t3357065474-cloud/STM32-Digital-Synchronous-Buck-Converter/实物PCB正面.jpg

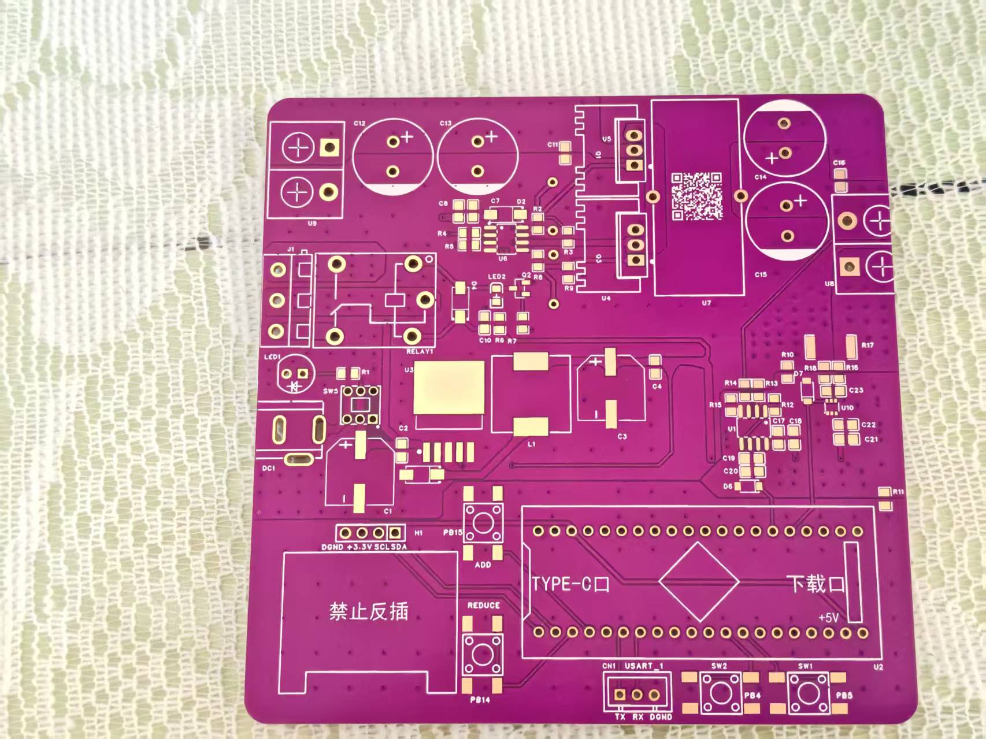
实物PCB正面.jpg
