t3357065474-cloud/STM32-Digital-Synchronous-Buck-Converter/2D_PCB2_2026-07-11.png

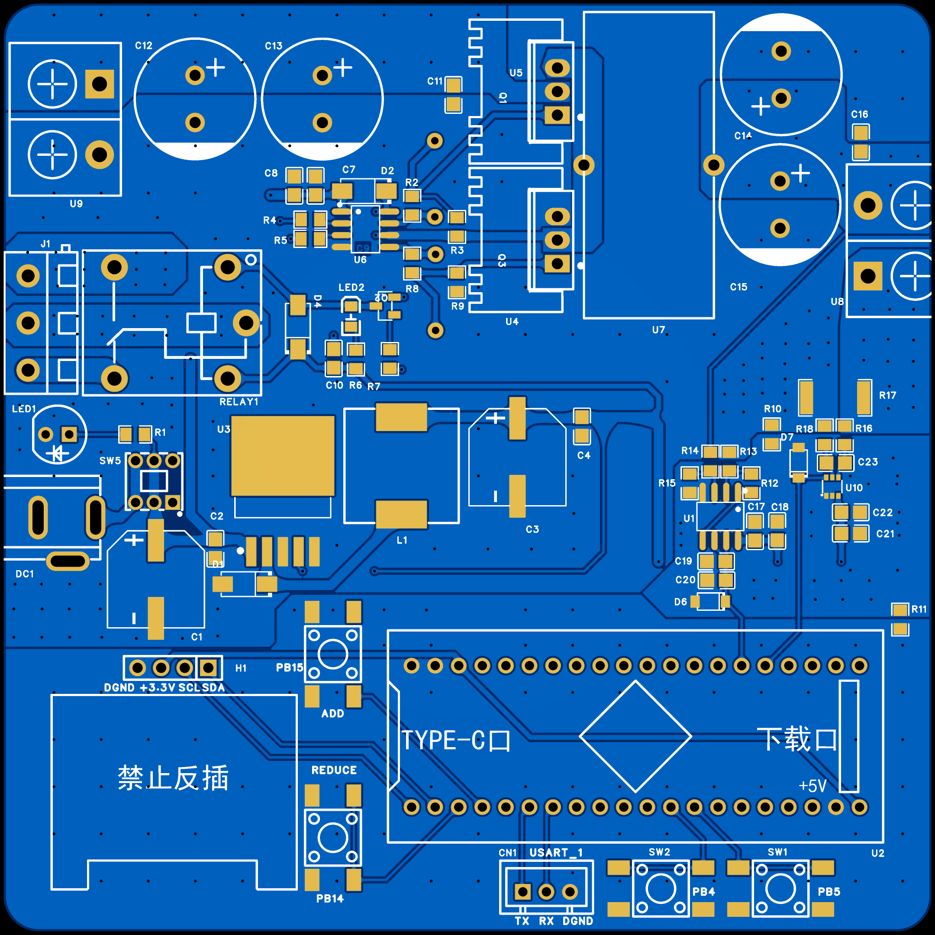
2D_PCB2_2026-07-11.png
