t3357065474-cloud/STM32-Digital-Synchronous-Buck-Converter/3D_PCB2_2026-07-11.png

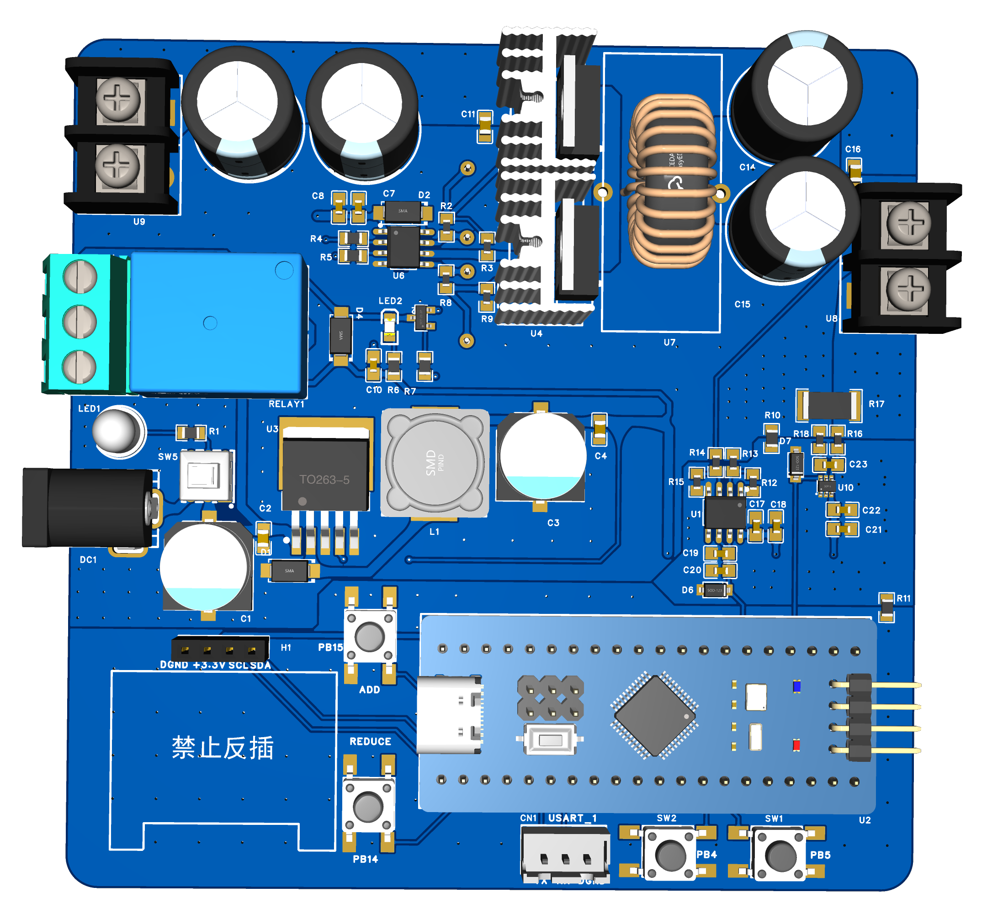
3D_PCB2_2026-07-11.png
