t3357065474-cloud/STM32-Digital-Synchronous-Buck-Converter/PCB_PCB2_2026-07-11.png

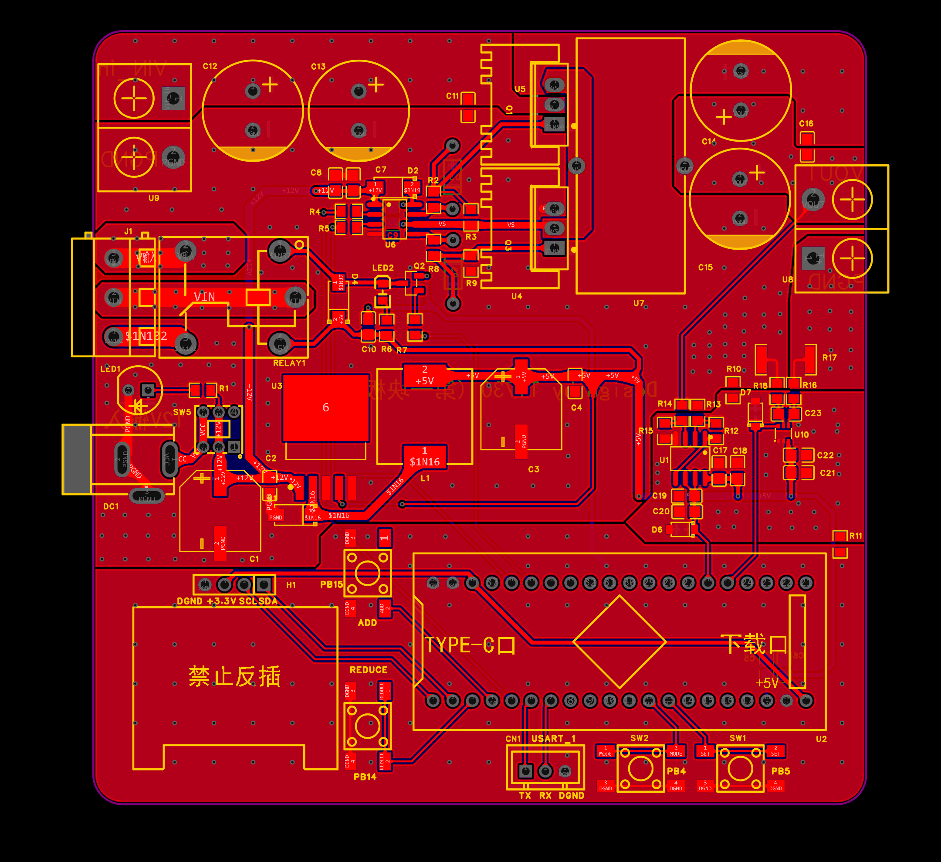
PCB_PCB2_2026-07-11.png
