t3357065474-cloud/STM32-Digital-Synchronous-Buck-Converter/SCH_Schematic1_1-P1_2026-07-11.png

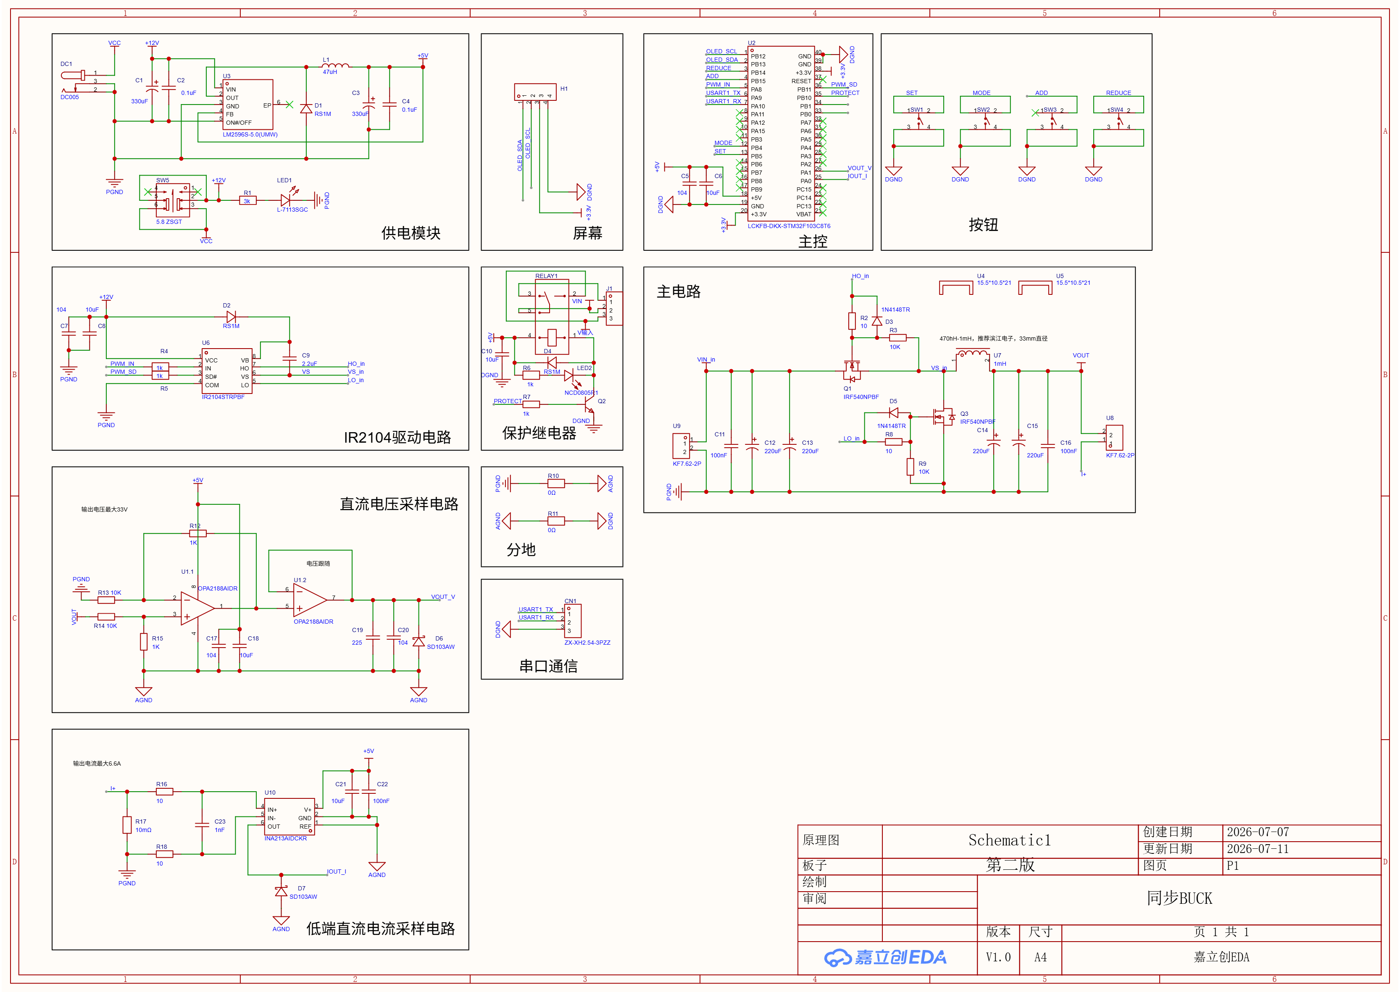
SCH_Schematic1_1-P1_2026-07-11.png
