t3357065474-cloud/STM32-Digital-Synchronous-Buck-Converter/焊接图2.jpg

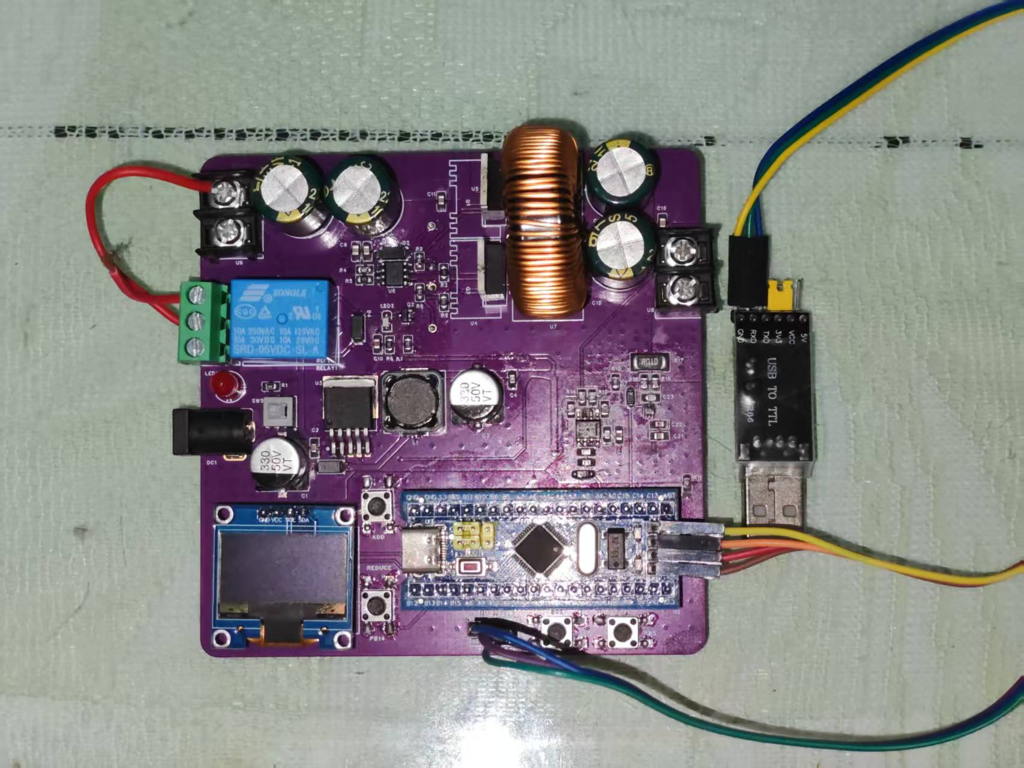
焊接图2.jpg
