t3357065474-cloud/STM32-Digital-Synchronous-Buck-Converter/BOM_第二版_Schematic1_2026-07-11.xlsx

No. | Quantity | Comment | Designator | Footprint | Value | Pin Count | LCSC Price | JLCPCB Price
1 | 2 | 330uF | C1,C3 | CAP-SMD_BD10.0-L10.3-W10.3-FD-LS11.0 | 330uF | 2 | 1.1384 | 1.138
2 | 2 | 0.1uF | C2,C4 | C0805 | 0.1uF | 2
3 | 4 | 104 | C5,C7,C17,C20 | C0805 | 104 | 2
4 | 5 | 10uF | C6,C8,C10,C18,C21 | C0805 | 10uF | 2
5 | 1 | 2.2uF | C9 | C0805 | 2.2uF | 2 | 3.05 | 3.05
6 | 2 | 100nF | C11,C16 | C0805 | 100nF | 2 | 0.1948 | 0.195
7 | 4 | 220uF | C12,C13,C14,C15 | CAP-TH_BD13.0-P5.00-D1.2-FD | 220uF | 2 | 1.3075 | 1.308
8 | 1 | 225 | C19 | C0805 | 225 | 2
9 | 1 | 100nF | C22 | C0805 | 100nF | 2
10 | 1 | 1nF | C23 | C0805 | 1nF | 2
11 | 1 | ZX-XH2.54-3PZZ | CN1 | CONN-TH_3P-P2.54_2501S-3P |  | 3 | 0.0727 | 0.0727
12 | 3 | RS1M | D1,D2,D4 | SMA_L4.3-W2.6-LS5.2-FD |  | 2 | 0.833 | 0.833
13 | 2 | 1N4148TR | D3,D5 | DO-35_BD2.0-L4.2-P8.20-D0.5-RD |  | 2 | 0.1228 | 0.123
14 | 2 | SD103AW | D6,D7 | SOD-123_L2.7-W1.6-LS3.7-RD |  | 2 | 0.0672 | 0.0672
15 | 1 | DC005 | DC1 | DC-IN-TH_DC005 |  | 3 | 0.334 | 0.334
16 | 1 | PM254V-11-04-H85 | H1 | HDR-TH_4P-P2.54-V-F |  | 4 | 0.43 | 0.43
17 | 1 | KF128-5.08-3P-AA | J1 | CONN-TH_3P-P5.08_KF128-5.08-3P |  | 3 | 1.9694 | 1.969
18 | 1 | 47uH | L1 | IND-SMD_L12.3-W12.3_SMDRI127 | 47uH | 2 | 2.4341 | 2.434
19 | 1 | L-7113SGC | LED1 | LED-TH_BD5.9-P2.54-FD |  | 2 | 0.9081 | 0.908
20 | 1 | NCD0805R1 | LED2 | LED0805-RD |  | 2 | 0.082 | 0.082
21 | 2 | IRF540NPBF | Q1,Q3 | TO-220-3_L10.0-W4.5-P2.54-L |  | 3 | 2.4857 | 2.486
22 | 1 | S9013 | Q2 | SOT-23-3_L2.9-W1.3-P0.95-LS2.4-BR |  | 3 | 0.0825 | 0.0825
23 | 1 | 3k | R1 | R0805 | 3k | 2
24 | 4 | 10 | R2,R8,R16,R18 | R0805 | 10 | 2
25 | 4 | 10K | R3,R9,R13,R14 | R0805 | 10K | 2
26 | 4 | 1k | R4,R5,R6,R7 | R0805 | 1k | 2
27 | 2 | 0Ω | R10,R11 | R0805 | 0Ω | 2 | 0.3452 | 0.345
28 | 2 | 1K | R12,R15 | R0805 | 1K | 2
29 | 1 | 10mΩ | R17 | R2512 | 10mΩ | 2 | 0.5111 | 0.511
30 | 1 | SRD-12VDC-SL-C | RELAY1 | RELAY-TH_SRD-XXVDC-XL-C |  | 5 | 2.4 | 2.4
31 | 4 | KH-6X6X5H-STM | SW1,SW2,SW3,SW4 | SW-SMD_4P-L6.0-W6.0-P4.50-LS9.0_H5.0 |  | 4 | 0.1153 | 0.115
32 | 1 | 5.8 ZSGT | SW5 | SW-TH_5.8ZSGT |  | 6 | 0.6139 | 0.614
33 | 1 | OPA2188AIDR | U1 | SOIC-8_L4.9-W3.9-P1.27-LS6.0-BL |  | 8 | 8.13 | 8.13
34 | 1 | LCKFB-DKX-STM32F103C8T6 | U2 | CONN-TH_L53.3-W22.9_STM32F103C8T6-CARD |  | 40 | 11.46 | 11.46
35 | 1 | LM2596S-5.0(UMW) | U3 | TO-263-5_L10.2-W8.9-P1.70-BR |  | 6 | 3.72 | 3.72
36 | 2 | 15.5*10.5*21 | U4,U5 | SINK-TH_L15.0-W10.5-H21.0 |  | 0 | 0.6343 | 0.634
37 | 1 | IR2104STRPBF | U6 | SOIC-8_L4.9-W3.9-P1.27-LS6.0-BL |  | 8 | 5.57 | 5.57
38 | 1 | 1mH | U7 | FILTER-TH_2P-L20.0-W9.0-P9.00-D1.0 | 1mH | 2
39 | 2 | KF7.62-2P | U8,U9 | CONN-TH_KF7.62-2P |  | 2 | 0.763 | 0.763
40 | 1 | INA213AIDCKR | U10 | TSSOP-6_L2.0-W1.3-P0.65-LS2.0-BR |  | 6 | 3.97 | 3.97
