t3357065474-cloud/STM32-Digital-Synchronous-Buck-Converter/Synchronous BUCK Converter Based on STM32/Core/Inc/main.h

#define PROTECT_Pin GPIO_PIN_10
#define PROTECT_GPIO_Port GPIOB
#define PWM_SD_Pin GPIO_PIN_11
#define PWM_SD_GPIO_Port GPIOB
#define OLED_SCL_Pin GPIO_PIN_12
#define OLED_SCL_GPIO_Port GPIOB
#define OLED_SDA_Pin GPIO_PIN_13
#define OLED_SDA_GPIO_Port GPIOB
#define REDUCE_Pin GPIO_PIN_14
#define REDUCE_GPIO_Port GPIOB
#define ADD_Pin GPIO_PIN_15
#define ADD_GPIO_Port GPIOB
#define MODE_Pin GPIO_PIN_4
#define MODE_GPIO_Port GPIOB
#define SET_Pin GPIO_PIN_5
#define SET_GPIO_Port GPIOB
