t3357065474-cloud/STM32-Digital-Synchronous-Buck-Converter/(commit log)

2026-08-08 上传完整同步BUCK项目：PCB硬件设计 + STM32固件代码
    包含内容：
    - 立创EDA工程 (.eprj2) + Gerber制板文件
    - 原理图、PCB 2D/3D渲染图、实物照片
    - STM32 固件源码 (Core/Inc + Core/Src)
    - MDK-ARM 工程文件 (.uvprojx, .sct, startup.s)
    - STM32CubeMX 配置 (.ioc)
    - MATLAB/Simulink 仿真模型
    说明：
    - ST HAL/CMSIS 库已通过 .gitignore 排除，
    克隆后用 STM32CubeMX 打开 .ioc 重新生成即可
    [BOM_第二版_Schematic1_2026-07-11.xlsx]
2026-08-08 Add comprehensive bilingual README (中英双语项目说明)
