t3357065474-cloud/STM32-Digital-Synchronous-Buck-Converter/(notices)

Notices in the files:
Synchronous BUCK Converter Based on STM32/Core/Inc/main.h:
Copyright (c) 2026 STMicroelectronics.
All rights reserved.
This software is licensed under terms that can be found in the LICENSE file
